desiFish/Smart-Aquarium-V4.0/(threads)

Thread 3 (2025-04-28):

Effect of Power Cycle on Timer

desiFish, 2025-04-28:
It shifts to manual mode after power cycle while running on timer

desiFish, 2025-04-28:
Timer mode can never continue after power cycle because of millis(). Well it can restart, but it can never continue.

Closed 2025-04-28.

Thread 6 (2025-04-28):

LCD Implementation

desiFish, 2025-04-28:
20x4 Onboard LCD for server-less quick updates.

desiFish, 2025-04-29:
Since this version is using webserver, I am putting away the LCD option, since all controls are available in web server. Rather I will use 4 WS2812B RGB LEDs for simple status purpose.
The LCD version along with buttons will feature in Smart Aquarium V4.1

Closed 2025-04-29.

Thread 7 (2025-04-29):

[Feature-Req] WS2812B LEDs as Status Indicator

desiFish, 2025-04-29:
LCD2004 will increase the cost and is not really required when this is purely web server based operation.

Using these RGB leds we can have quick statuses. In settings we can choose "Always ON" or "Press to ON for 5 seconds".
There can be more options like LED brightness, how long to stay ON before turning OFF.
LED-Based Error Codes.
Different colour for different modes.
