desiFish/Smart-Aquarium-V4.0/(commit log)

2025-04-24 Refactor Project_Mina.ino to implement OTA updates and web server for LED control
2025-04-25 temp3: fetch state of relay onload else disable
2025-04-25 test4: New settings page for renaming relays with update rtc time button
2025-04-25 - added endpoints for status, version, name get and set, relay state, relay on off status - added a new image in readme some other minor changes
2025-04-26 - added more api connectivity - added class based operation - Fixed other stuffs - auto mode time set, timer mode set NOT WORKING - Mode change working - Added fevicon
2025-04-27 remove unused ledPin variable and related pinMode call in setup
2025-04-27 remove unused timerStarter and timerDuration variables from AsyncWebServer setup
2025-04-27 update README.md with upcoming and current features; adjust program storage usage comment in Project_Mina.ino
2025-04-27 add dual-core ESP32 support note to features list in README.md
2025-04-27 add hardware compatibility note for ESP32 DevKit V1 in README.md
2025-04-28 - fixed issues in timer mode - added countdown animation sync with backend
2025-04-29 - added schematics - added theme colour in settings.html
2025-04-29 docs: add tentative circuit schematic V4.0 to README
2026-08-22 v0.3.0-beta dynamic relay number
2026-08-22 for v0.3.0 other fixes
    [Smart-Aquarium-V4.0.ino]
2026-08-29 V0.4.0-beta adding display, buzzer, rgb led, and buttons
    [Smart-Aquarium-V4.0.ino]
2026-08-29 v0.4.1-beta small improvements and fixes
    [Smart-Aquarium-V4.0.ino]
2026-08-30 v0.4.2-beta added error handling and other fixes
    [Smart-Aquarium-V4.0.ino]
